UCI-Rocket-Project/rocket2-afs-hardware/rocket2-afs.kicad_pcb

## KiCad design rocket2-afs.kicad_pcb (2024-08-27)

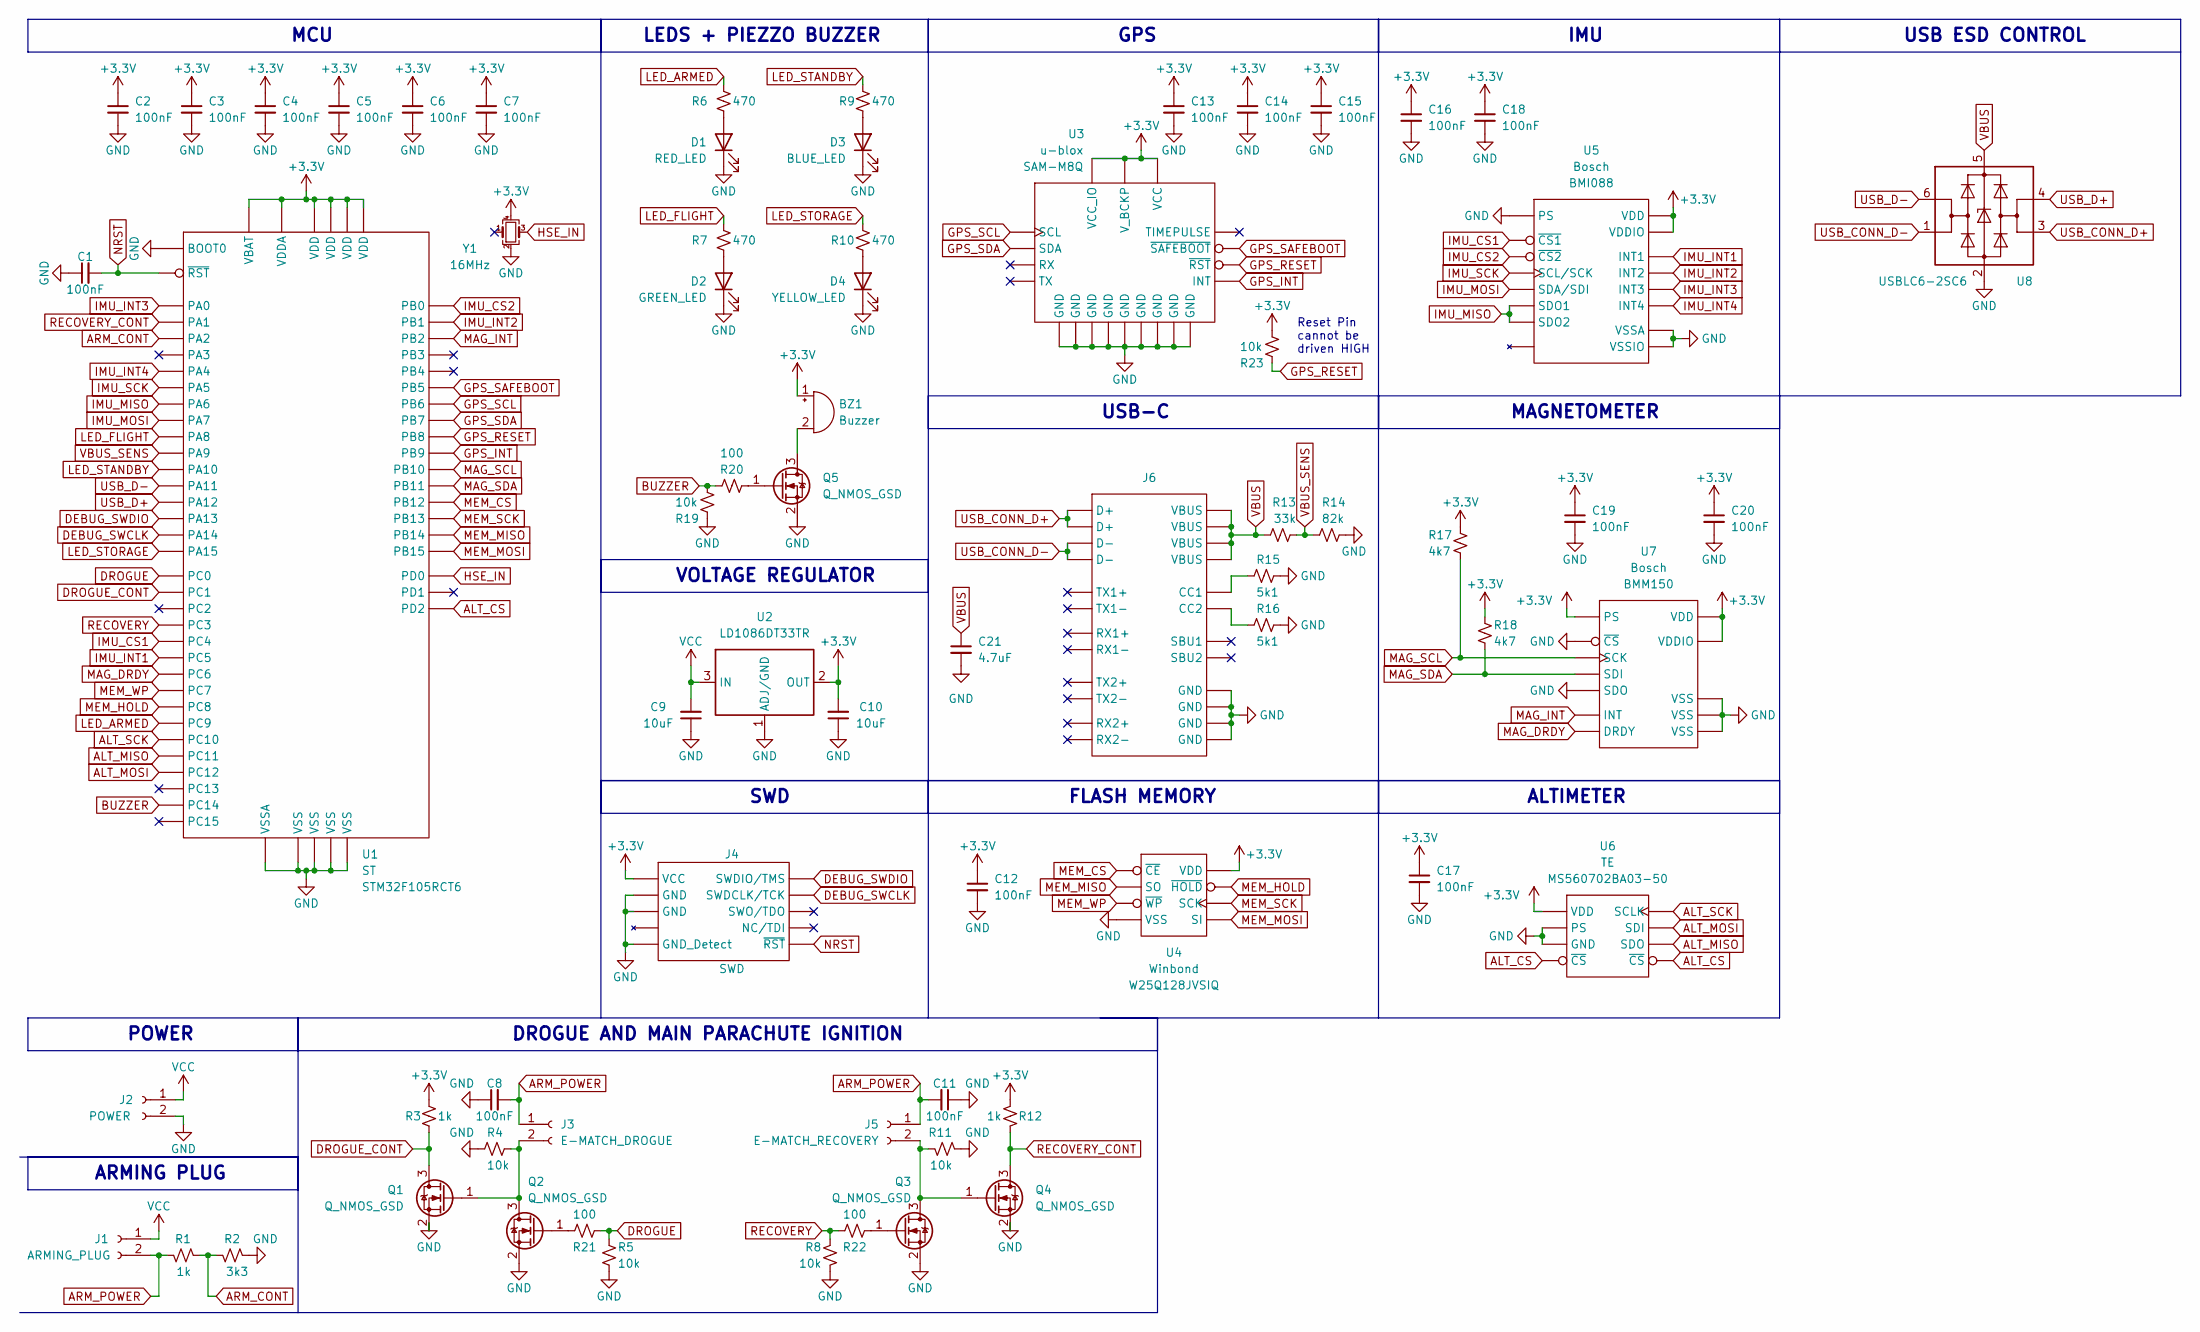
[picture p1: schematic rocket2-afs.kicad_sch]

Parts:
BZ1: Buzzer; Buzzer_CUI_CPT-9019S-SMT; Part # CMI-9653S-SMT-TR
C1, C2, C3, C4, C5, C6, C7, C8, C11, C12, C13, C14, C15, C16, C17, C18, C19, C20: 100nF; C_0603_1608Metric; Part # Generic 0603 6.3V 100nF X7R MLCC
C9, C10: 10uF; C_0603_1608Metric; Part # Generic 0603 6.3V 10uF X7R MLCC
C21: 4.7uF; C_0603_1608Metric; Part # Generic 0603 6.3V 4.7uF X7R MLCC
D1: RED_LED; D_0603_1608Metric; Part # Generic Red LED
D2: GREEN_LED; D_0603_1608Metric; Part # Generic Green LED
D3: BLUE_LED; D_0603_1608Metric; Part # Generic Blue LED
D4: YELLOW_LED; D_0603_1608Metric; Part # Generic Yellow LED
J1: ARMING_PLUG; TerminalBlock_bornier-2_P5.08mm; Part # Generic Horizontal TH P5.08mm Screw Fas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
J2: POWER; TerminalBlock_bornier-2_P5.08mm; Part # Generic Horizontal TH P5.08mm Screw Fas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
J3: E-MATCH_DROGUE; TerminalBlock_bornier-2_P5.08mm; Part # Generic Horizontal TH P5.08mm Screw Fas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
J4: SWD; PinHeader_2x05_P1.27mm_Vertical_SMD; Part # Generic 2x05 P1.27mm Vertical Pin Heade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
J5: E-MATCH_RECOVERY; TerminalBlock_bornier-2_P5.08mm; Part # Generic Horizontal TH P5.08mm Screw Fas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
J6: USB_C_Receptacle_GCT_USB4105-xx-A_16P_TopMnt_Horizontal; Part # USB4105-GF-A
Q1, Q2, Q3, Q4, Q5: Q_NMOS_GSD; TSOT-23; Part # PMV30UN2
R1, R3, R12: 1k; R_0603_1608Metric; Part # Generic 0603 1k 1% Resistor
R2: 3k3; R_0603_1608Metric; Part # Generic 0603 3.3k 1% Resistor
R4, R5, R8, R11, R19, R23: 10k; R_0603_1608Metric; Part # Generic 0603 10k 1% Resistor
R6, R7, R9, R10: 470; R_0603_1608Metric; Part # Generic 0603 470 1% Resistor
R13: 33k; R_0603_1608Metric; Part # Generic 0603 33k 1% Resistor
R14: 82k; R_0603_1608Metric; Part # Generic 0603 82k 1% Resistor
R15, R16: 5k1; R_0603_1608Metric; Part # Generic 0603 5.1k 1% Resistor
R17, R18: 4k7; R_0603_1608Metric; Part # Generic 0603 4.7k 1% Resistor
R20, R21, R22: 100; R_0603_1608Metric; Part # Generic 0603 100 1% Resistor
U1: LQFP-64_10x10mm_P0.5mm; Part # STM32F105RCT6
U2: LD1086DT33TR; TO-252-2; Part # LD1086DT33TR
U3: ublox_SAM-M8Q; Part # SAM-M8Q
U4: SOIC-8W_5.3x5.3mm_P1.27mm; Part # W25Q128JVSIQ
U5: BMI088; Part # BMI088
U6: MS5607-02BA; Part # MS560702BA03-50
U7: WLCSP-12_1.56x1.56mm_P0.4mm; Part # BMM150
U8: USBLC6-2SC6; SOT-23-6; Part # USBLC6-2SC6
Y1: 16MHz; Crystal_SMD_2520-4Pin_2.5x2.0mm; Part # ECS-1633-160-BN-TR

Connections:
+3.3V: BZ1.1 (+), C2.1, C3.1, C4.1, C5.1, C6.1, C7.1, C10.2, C12.1, C13.1, C14.1, C15.1, C16.1, C17.1, C18.1, C19.1, C20.1, J4.1 (VCC), R3.1, R12.1, R17.1, R18.1, R23.1, U1.1 (VBAT), U1.13 (VDDA), U1.19 (VDD), U1.32 (VDD), U1.48 (VDD), U1.64 (VDD), U2.2 (OUT), U3.2 (VCC_IO), U3.3 (V_BCKP), U3.17 (VCC), U4.8 (VDD), U5.3 (VDD), U5.11 (VDDIO), U6.1 (VDD), U7.A1 (PS), U7.B2 (VDDIO), U7.E5 (VDD), Y1.4
ALT_CS: U1.54 (PD2), U6.4 (~CS), U6.5 (~CS)
ALT_MISO: U1.52 (PC11), U6.6 (SDO)
ALT_MOSI: U1.53 (PC12), U6.7 (SDI)
ALT_SCK: U1.51 (PC10), U6.8 (SCLK)
ARM_CONT: R1.2, R2.1, U1.16 (PA2)
ARM_POWER: C8.2, C11.2, J1.2, J3.1, J5.1, R1.1
BUZZER: R19.1, R20.1, U1.3 (PC14)
DEBUG_SWCLK: J4.4 (SWDCLK/TCK), U1.49 (PA14)
DEBUG_SWDIO: J4.2 (SWDIO/TMS), U1.46 (PA13)
DROGUE: R5.1, R21.2, U1.8 (PC0)
DROGUE_CONT: Q1.3 (D), R3.2, U1.9 (PC1)
GND: C1.1, C2.2, C3.2, C4.2, C5.2, C6.2, C7.2, C8.1, C9.1, C10.1, C11.1, C12.2, C13.2, C14.2, C15.2, C16.2, C17.2, C18.2, C19.2, C20.2, C21.2, D1.1 (K), D2.1 (K), D3.1 (K), D4.1 (K), J2.2, J4.3 (GND), J4.5 (GND), J4.9 (GND_Detect), J6.A1 (GND), J6.A12 (GND), J6.B1 (GND), J6.B12 (GND), Q1.2 (S), Q2.2 (S), Q3.2 (S), Q4.2 (S), Q5.2 (S), R2.2, R4.2, R5.2, R8.2, R11.2, R14.1, R15.1, R16.1, R19.2, U1.12 (VSSA), U1.18 (VSS), U1.31 (VSS), U1.47 (VSS), U1.60 (BOOT0), U1.63 (VSS), U2.1 (ADJ/GND), U3.1 (GND), U3.4 (GND), U3.5 (GND), U3.6 (GND), U3.10 (GND), U3.11 (GND), U3.15 (GND), U3.16 (GND), U3.20 (GND), U4.4 (VSS), U5.4 (VSSA), U5.6 (VSSIO), U5.7 (PS), U6.2 (PS), U6.3 (GND), U7.A5 (~CS), U7.C1 (SDO), U7.C5 (VSS), U7.E1 (VSS), U7.E3 (VSS), U8.2 (GND), Y1.2
GPS_INT: U1.62 (PB9), U3.19 (INT)
GPS_RESET: R23.2, U1.61 (PB8), U3.18 (~RST)
GPS_SAFEBOOT: U1.57 (PB5), U3.8 (~SAFEBOOT)
GPS_SCL: U1.58 (PB6), U3.12 (SCL)
GPS_SDA: U1.59 (PB7), U3.9 (SDA)
HSE_IN: U1.5 (PD0), Y1.3
IMU_CS1: U1.24 (PC4), U5.14 (~CS1)
IMU_CS2: U1.26 (PB0), U5.5 (~CS2)
IMU_INT1: U1.25 (PC5), U5.16 (INT1)
IMU_INT2: U1.27 (PB1), U5.1 (INT2)
IMU_INT3: U1.14 (PA0), U5.12 (INT3)
IMU_INT4: U1.20 (PA4), U5.13 (INT4)
IMU_MISO: U1.22 (PA6), U5.10 (SDO2), U5.15 (SDO1)
IMU_MOSI: U1.23 (PA7), U5.9 (SDA/SDI)
IMU_SCK: U1.21 (PA5), U5.8 (SCL/SCK)
LED_ARMED: R6.1, U1.40 (PC9)
LED_FLIGHT: R7.1, U1.41 (PA8)
LED_STANDBY: R9.1, U1.43 (PA10)
LED_STORAGE: R10.1, U1.50 (PA15)
MAG_DRDY: U1.37 (PC6), U7.D4 (DRDY)
MAG_INT: U1.28 (PB2), U7.D2 (INT)
MAG_SCL: R17.2, U1.29 (PB10), U7.A3 (SCK)
MAG_SDA: R18.2, U1.30 (PB11), U7.B4 (SDI)
MEM_CS: U1.33 (PB12), U4.1 (~CE)
MEM_HOLD: U1.39 (PC8), U4.7 (~HOLD)
MEM_MISO: U1.35 (PB14), U4.2 (SO)
MEM_MOSI: U1.36 (PB15), U4.5 (SI)
MEM_SCK: U1.34 (PB13), U4.6 (SCK)
MEM_WP: U1.38 (PC7), U4.3 (~WP)
NRST: C1.2, J4.10 (~RST), U1.7 (~RST)
unnamed: BZ1.2 (-), Q5.3 (D)
unnamed: D1.2 (A), R6.2
unnamed: D2.2 (A), R7.2
unnamed: D3.2 (A), R9.2
unnamed: D4.2 (A), R10.2
unnamed: J3.2, Q1.1 (G), Q2.3 (D), R4.1
unnamed: J5.2, Q3.3 (D), Q4.1 (G), R11.1
unnamed: J6.A5 (CC1), R15.2
unnamed: J6.B5 (CC2), R16.2
unnamed: Q2.1 (G), R21.1
unnamed: Q3.1 (G), R22.2
unnamed: Q5.1 (G), R20.2
RECOVERY: R8.1, R22.1, U1.11 (PC3)
RECOVERY_CONT: Q4.3 (D), R12.2, U1.15 (PA1)
USB_CONN_D+: J6.A6 (D+), J6.B6 (D+), U8.3 (I/O2)
USB_CONN_D-: J6.A7 (D-), J6.B7 (D-), U8.1 (I/O1)
USB_D+: U1.45 (PA12), U8.4 (I/O2)
USB_D-: U1.44 (PA11), U8.6 (I/O1)
VBUS: C21.1, J6.A4 (VBUS), J6.A9 (VBUS), J6.B4 (VBUS), J6.B9 (VBUS), R13.1, U8.5 (VBUS)
VBUS_SENS: R13.2, R14.2, U1.42 (PA9)
VCC: C9.2, J1.1, J2.1, U2.3 (IN)

Notes on the sheet:
POWER
USB ESD CONTROL
ARMING PLUG
SWD
MCU
ALTIMETER
Reset Pin cannot be driven HIGH
GPS
IMU
MAGNETOMETER
FLASH MEMORY
USB-C
LEDS + PIEZZO BUZZER
DROGUE AND MAIN PARACHUTE IGNITION
VOLTAGE REGULATOR

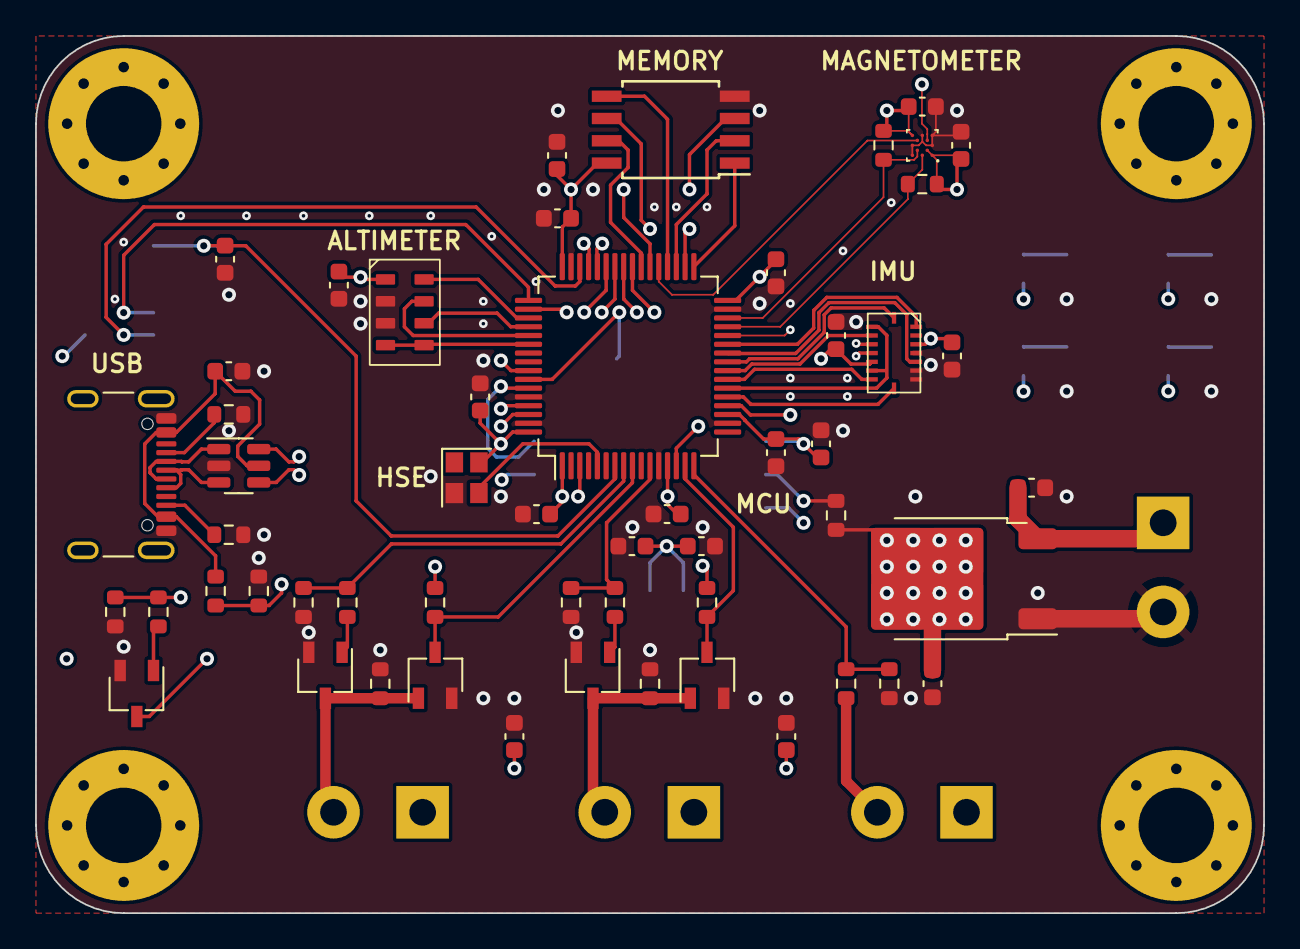
[picture p2: board rocket2-afs.kicad_pcb from above]

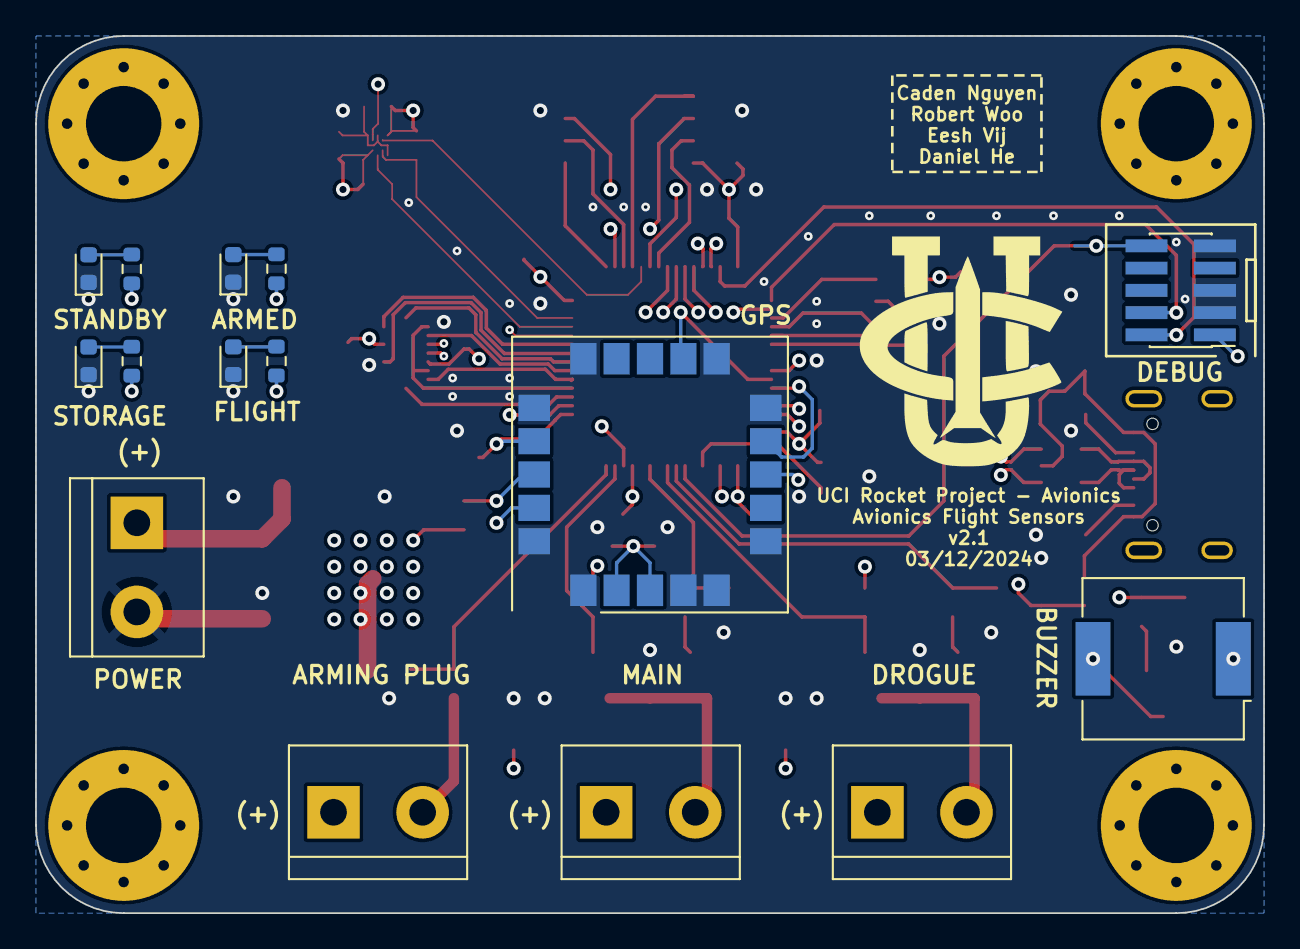
[picture p3: board rocket2-afs.kicad_pcb from below]

Board: 4 copper layers, 70.0 x 50.0 mm, 69 parts (15 on the bottom side), 64 nets.
