UCI-Rocket-Project/rocket2-afs-hardware/(commit log)

2024-02-08 Finalized Schematic. PCB is WIP by 02-11-2024
    [rocket2-afs.kicad_pcb, rocket2-afs.kicad_sch, template.kicad_sch]
2024-02-11 Fixed HSE pinout. Updated Crystal circuit.
    [rocket2-afs.kicad_sch]
2024-02-12 Adjusted Symbol Libraries for USB-C and Piezo Buzzer
    [rocket2-afs.kicad_sch]
2024-02-14 New MI-9653S-SMT-TR Buzzer and Buzzer Circuit. Added power footprint.
    [rocket2-afs.kicad_pcb, rocket2-afs.kicad_sch]
2024-02-21 Complete PCB, first iteration
    [rocket2-afs.kicad_pcb, rocket2-afs.kicad_sch]
2024-02-26 Current limiting resistors to MOSFETs. Silkscreen names + Logo. Adjusted BMI088 footprint as per ERC error (LOCAL TO PCB).
    [rocket2-afs.kicad_pcb, rocket2-afs.kicad_sch]
2024-02-29 wrote in comments
    [rocket2-afs.kicad_sch]
2024-03-04 Adjusted to M4 Screws
    [rocket2-afs.kicad_pcb]
2024-03-06 Completely Remade PCB to adjust for GPS GND Shield
    [rocket2-afs.kicad_pcb, rocket2-afs.kicad_sch]
2024-03-11 Silkscreen Changes for Readability
    [rocket2-afs.kicad_pcb]
2024-03-12 Completely Remade PCB to Space out Components
    [rocket2-afs.kicad_pcb, rocket2-afs.kicad_sch]
2024-03-13 Moved All Thick Components to "Front" Layer. Added Silkscreens
    [rocket2-afs.kicad_pcb, rocket2-afs.kicad_sch]
2024-03-13 Silkscreen update.
    [rocket2-afs.kicad_pcb]
2024-03-13 Adjusted VBUS
    [rocket2-afs.kicad_pcb, rocket2-afs.kicad_sch]
2024-03-13 Moved BOOT0 Schematic to RST
    [rocket2-afs.kicad_pcb, rocket2-afs.kicad_sch]
2024-03-13 Updated Generic Component Assignment
    [rocket2-afs.kicad_sch]
2024-03-13 Silkscreen for debugger
    [rocket2-afs.kicad_pcb]
2024-03-14 Updated Generic Component Descriptions
    [rocket2-afs.kicad_sch]
2024-03-14 Changed Debug Symbol to UCIRP-L Library footrpint
    [rocket2-afs.kicad_pcb, rocket2-afs.kicad_sch]
2024-03-14 Final tweaks
    [rocket2-afs.kicad_pcb, rocket2-afs.kicad_sch]
2024-08-27 Added GPS RESET pullup resistor to PCB
    [rocket2-afs.kicad_pcb, rocket2-afs.kicad_sch]
